DenWaritthon/CarverSeekBot/robot_description/models/Wheel.STL

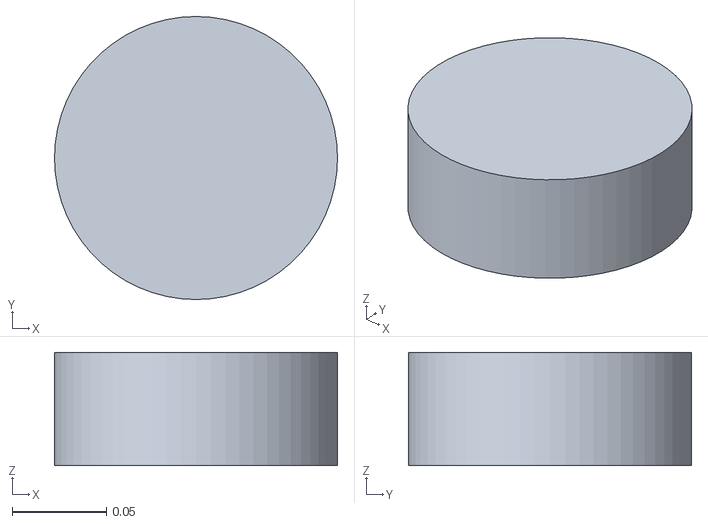
[picture p4: CAD file, 2025-05-24]
robot_description/models/Wheel.STL
0.15 x 0.15 x 0.06
