DenWaritthon/CarverSeekBot/robot_description/models/FrameNew.STL

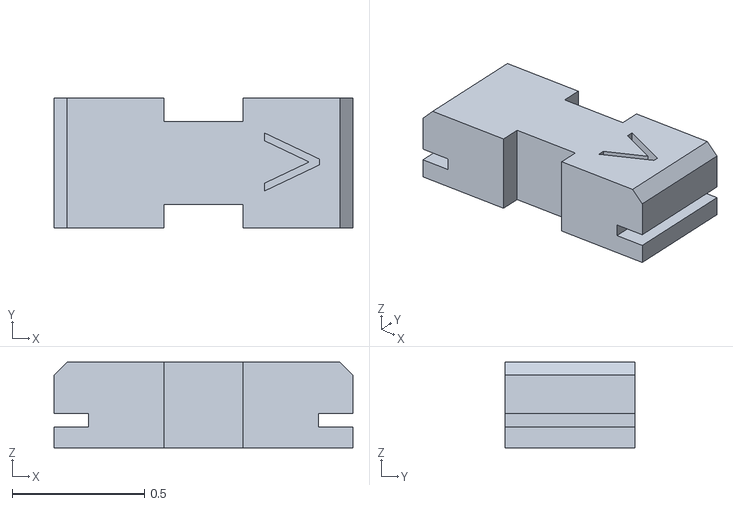
[picture p5: CAD file, 2025-05-24]
robot_description/models/FrameNew.STL
1.13 x 0.493 x 0.325
