DenWaritthon/CarverSeekBot/Electrical Schematic.pdf

-C1 | -C2

# Power Source (PSU Box)

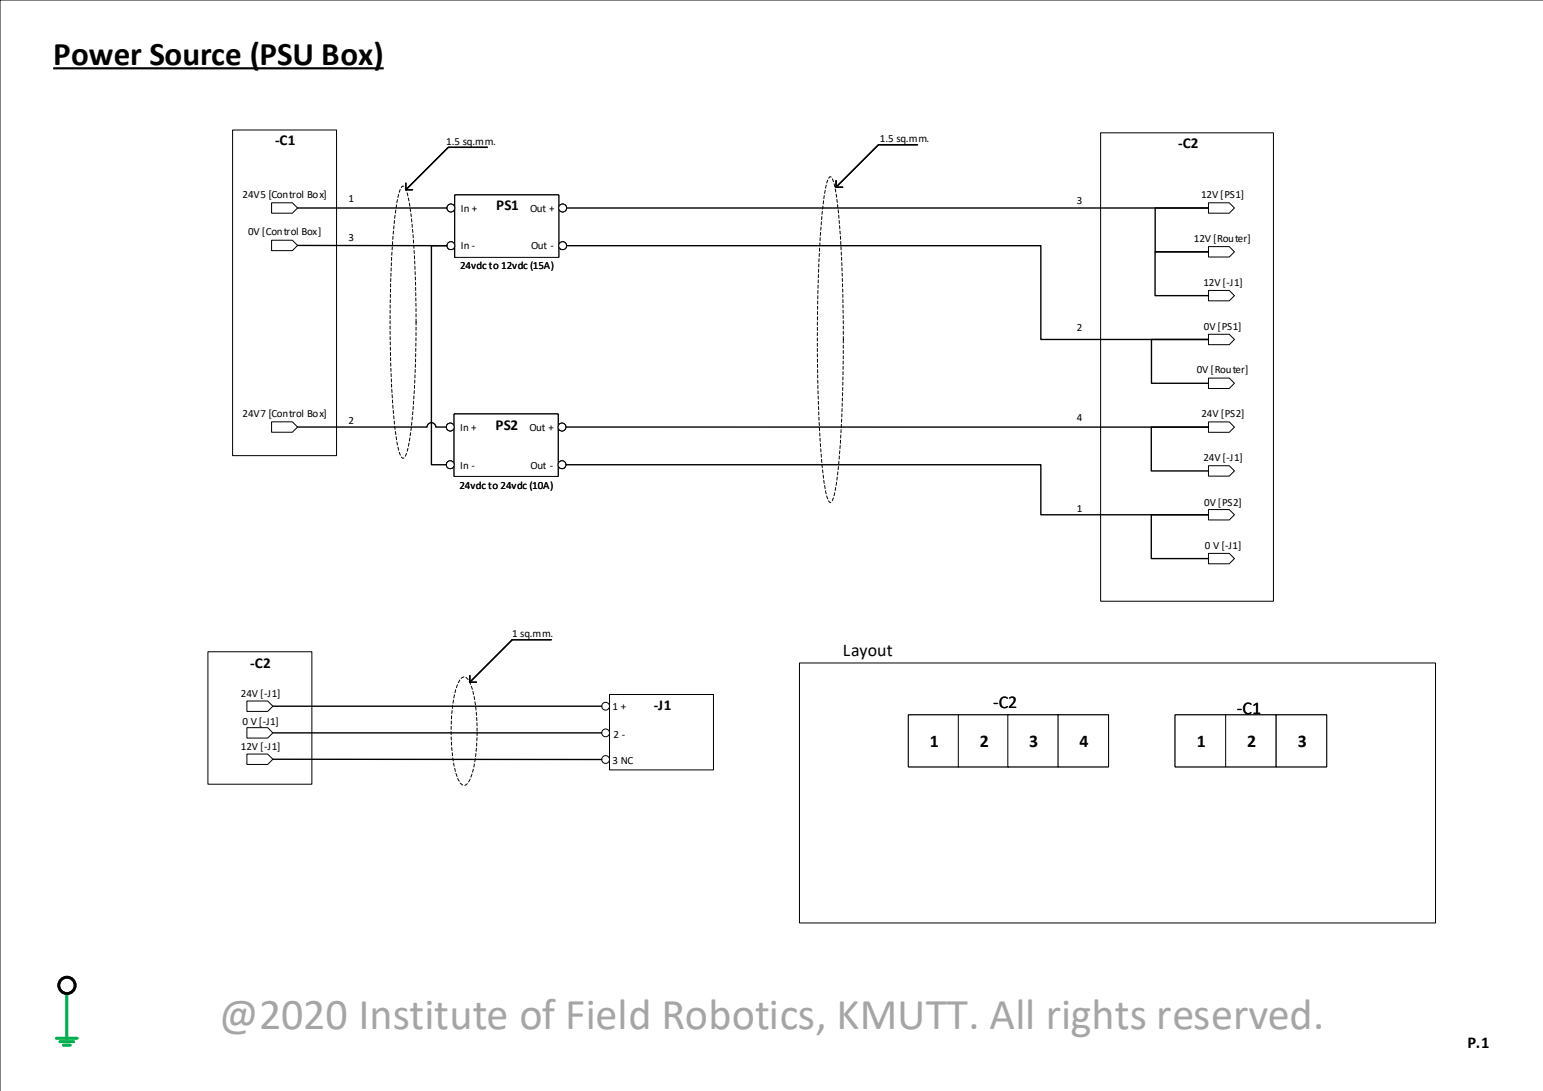
[picture p6: page 1]
Out +; Out -; 24vdc to 12vdc (15A); 0V [Control Box]; 24vdc to 24vdc (10A); 24V7 [Control Box]; 24V5 [Control Box]; 12V [Router]; 0V [Router]; Layout

@2020 Institute of Field Robotics, KMUTT. All rights reserved.

# Power Source (Control Box)

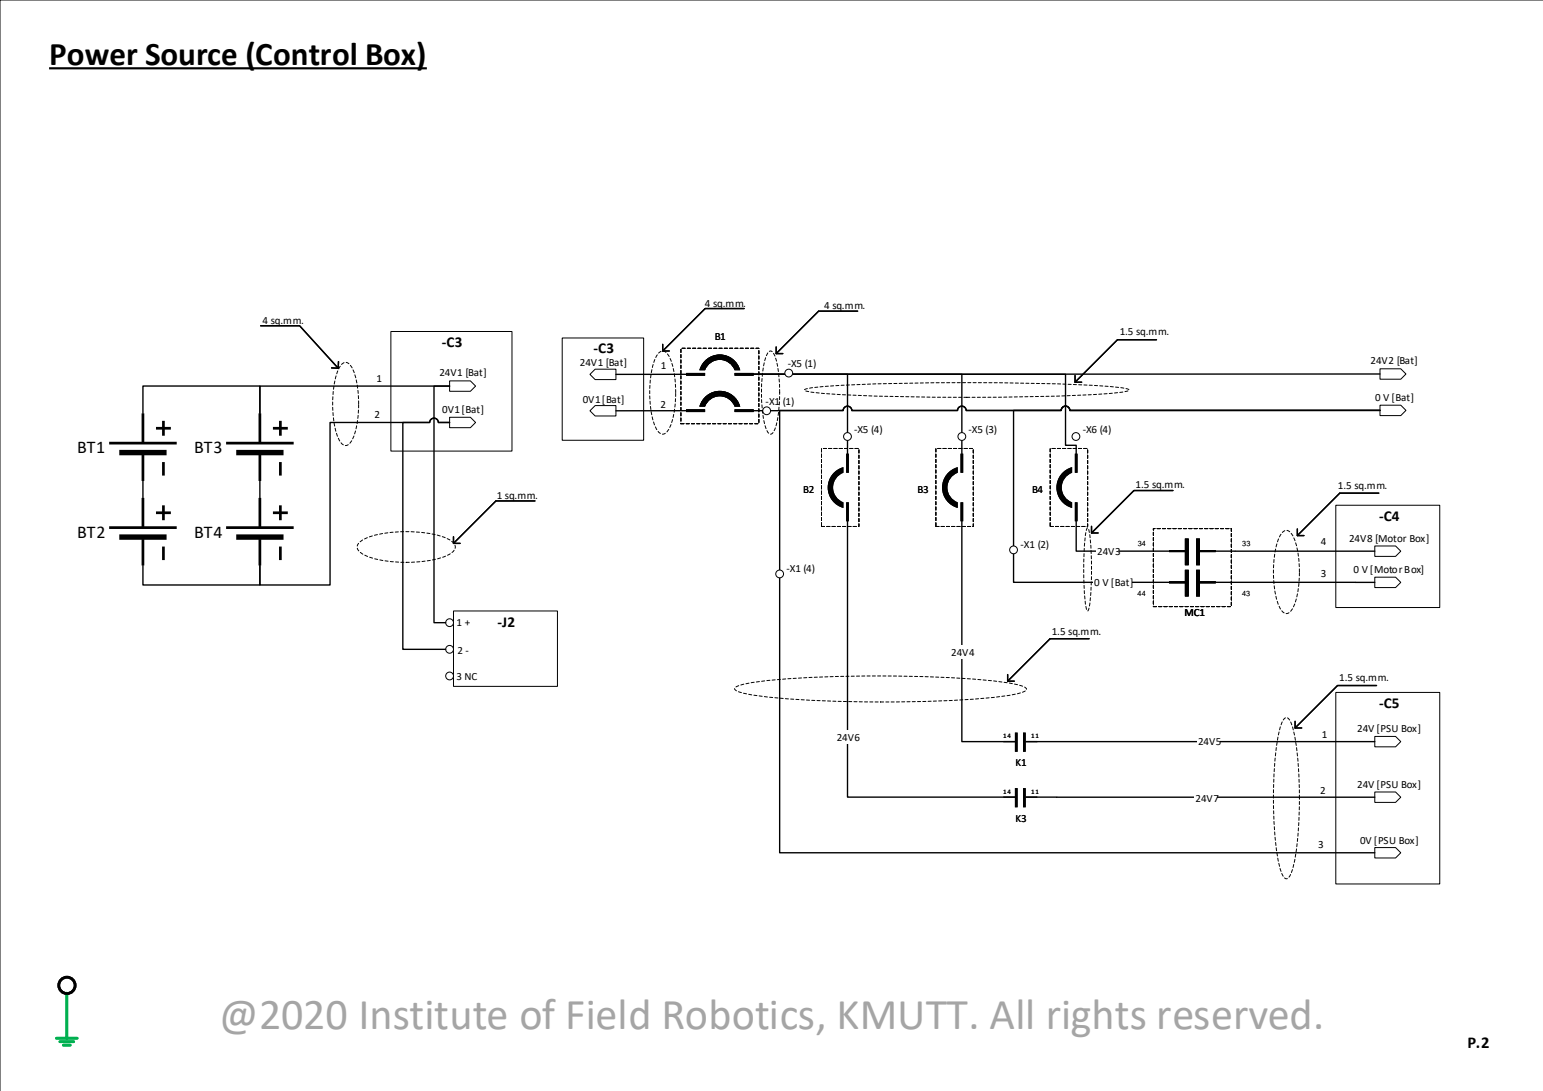
[picture p7: page 2]
24V2 [Bat]; 0 V [Bat]; 24V8 [Motor Box]; 0 V [Motor Box]; 24V [PSU Box]; 0V [PSU Box]; 24V1 [Bat]; 0V1 [Bat]

-C8

# Fused Module

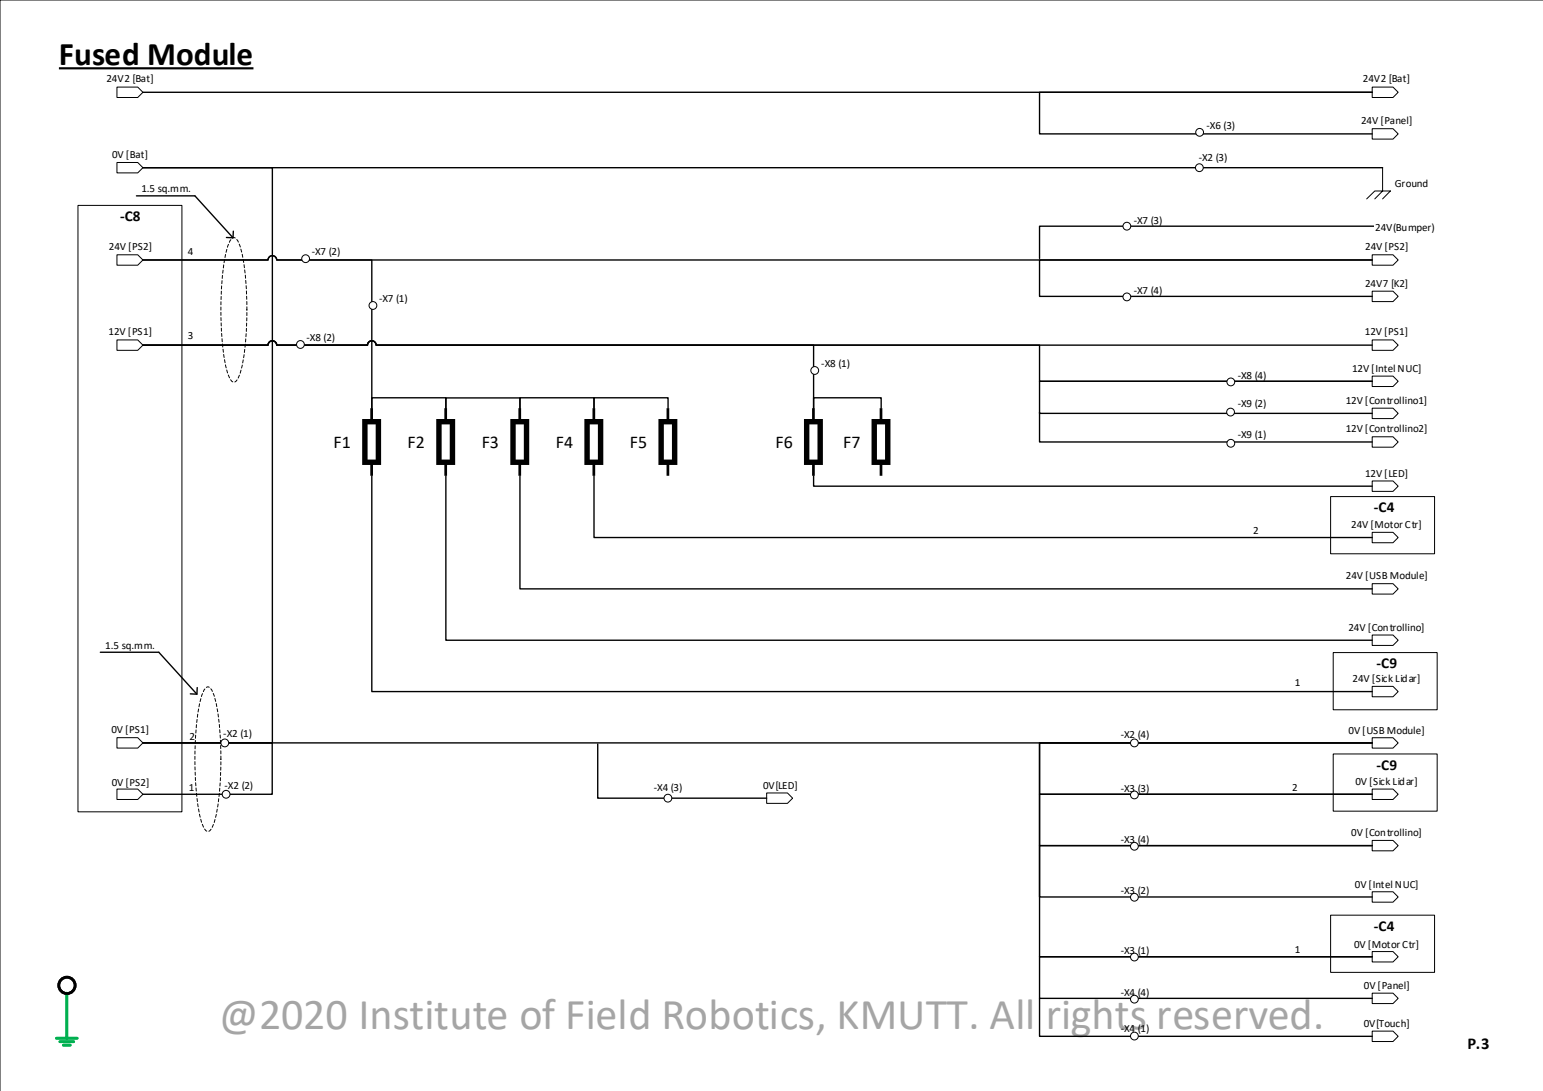
[picture p8: page 3]
24V2 [Bat]; 0V [Bat]; Ground; 24V [Sick Lidar]; 24V [Controllino]; 12V [LED]; 24V [USB Module]; 24V [Motor Ctr]; 0V [USB Module]; 0V [Sick Lidar]; 0V [Controllino]; 0V [Motor Ctr]; 12V [Intel NUC]; 0V [Intel NUC]; 24V [Panel]; 12V [Controllino1]; 0V [Panel]; 24V(Bumper) -X7 (3); 12V [Controllino2]; 0V[Touch]; 0V[LED]

-C6 | -C7

# Panel

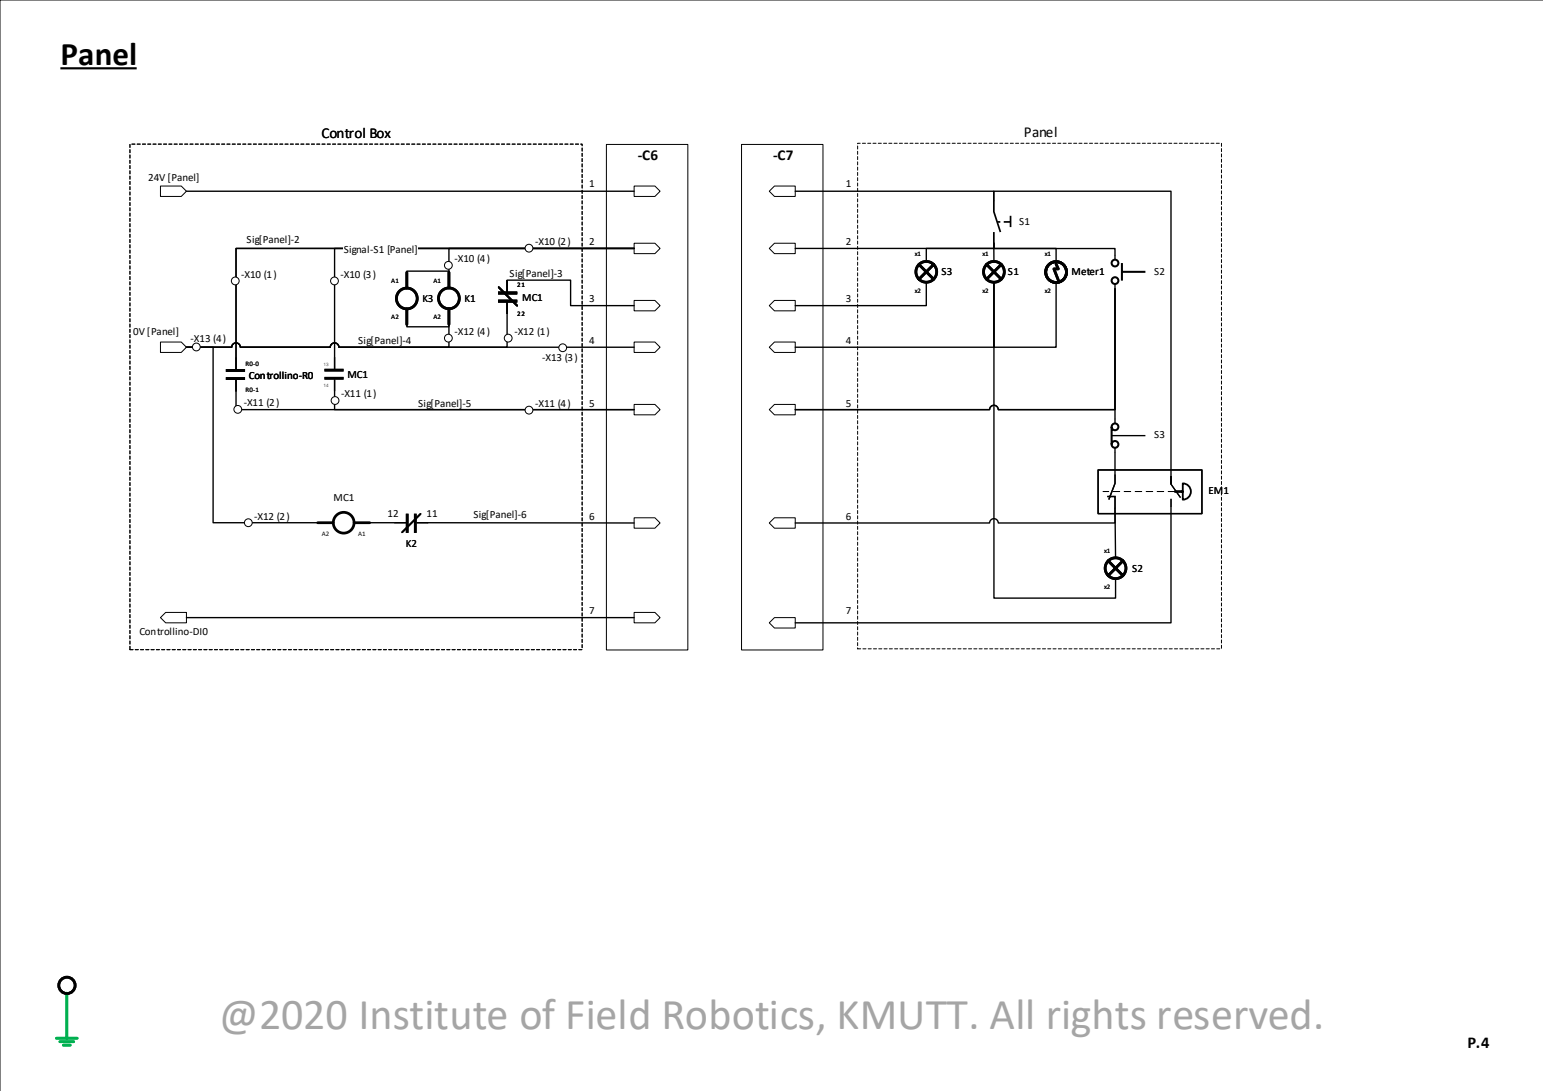
[picture p9: page 4]
24V [Panel]; 0V [Panel]; Signal-S1 [Panel]; Controllino-R0; Control Box; Panel; Controllino-DI0; Meter1; Sig[Panel]-2; Sig[Panel]-4; Sig[Panel]-3; Sig[Panel]-5; Sig[Panel]-6

-C10

# Motor Controller

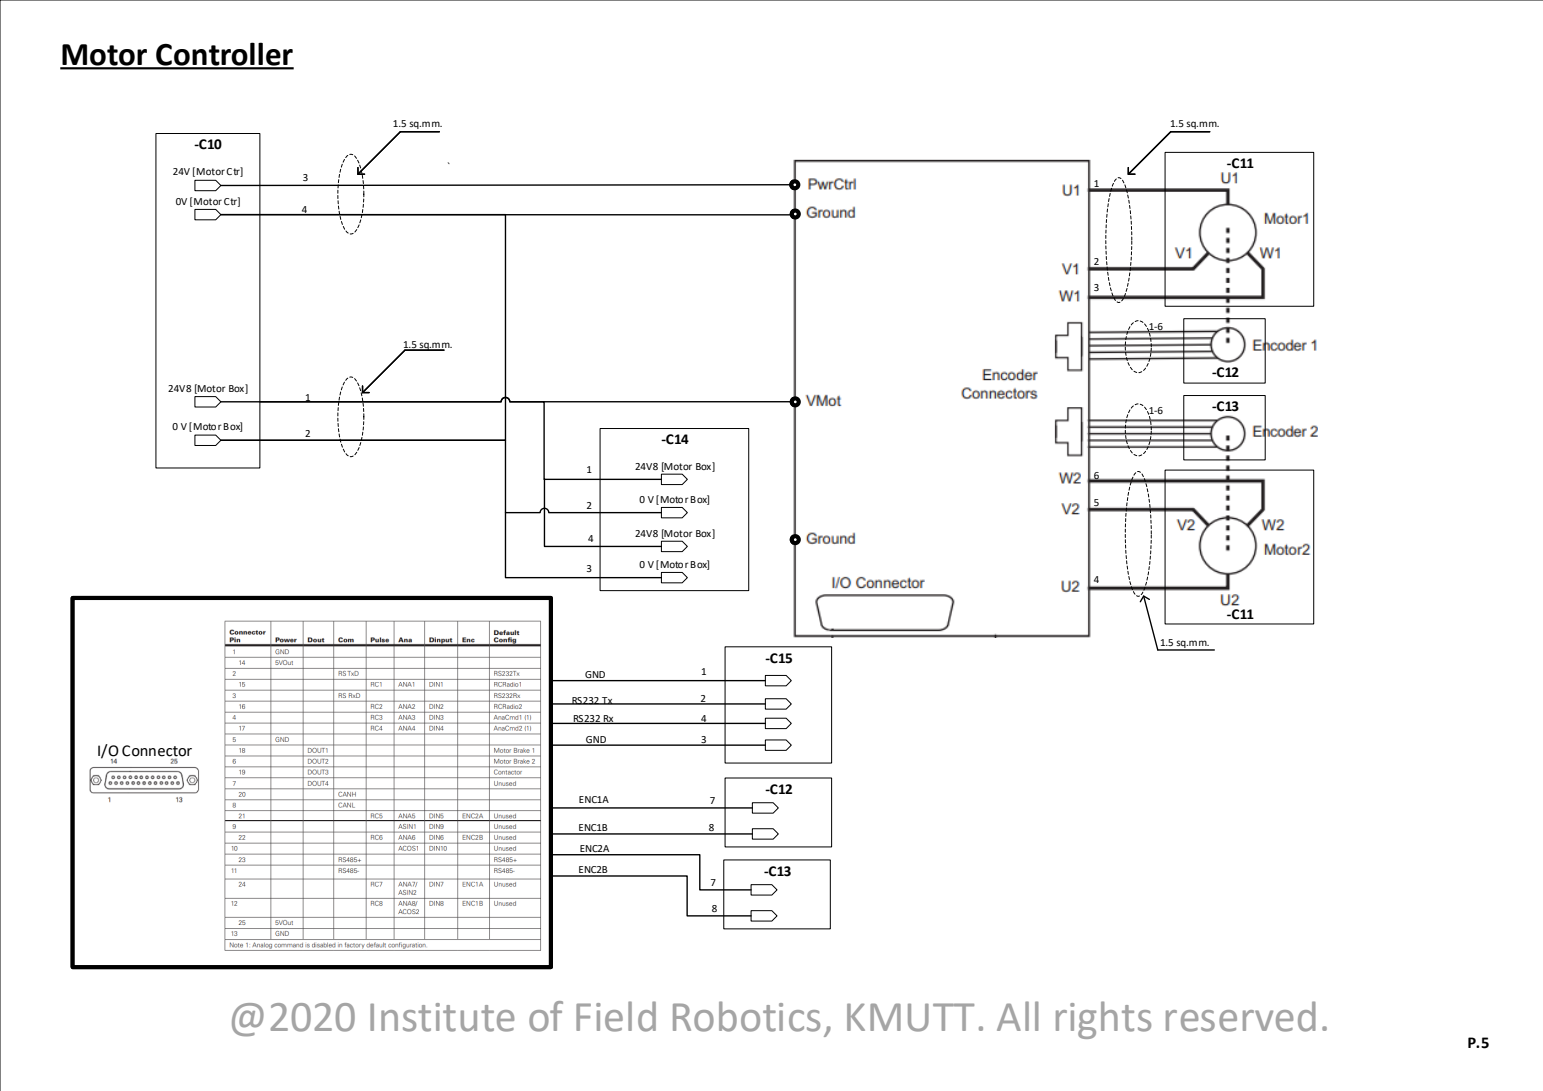
[picture p10: page 5]
I/O Connector; 24V [Motor Ctr]; 0V [Motor Ctr]; 24V8 [Motor Box]; 0 V [Motor Box]; GND; ENC1A; ENC1B; ENC2A

ENC2B

## For connector C12, C13

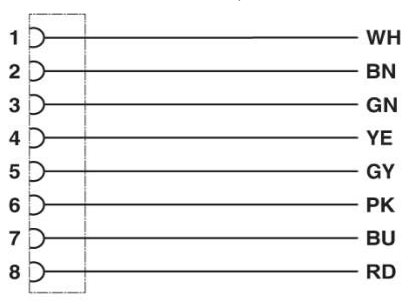
[picture p11: figure]
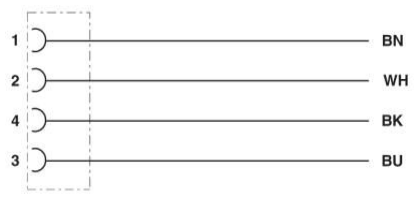
[picture p12: figure]
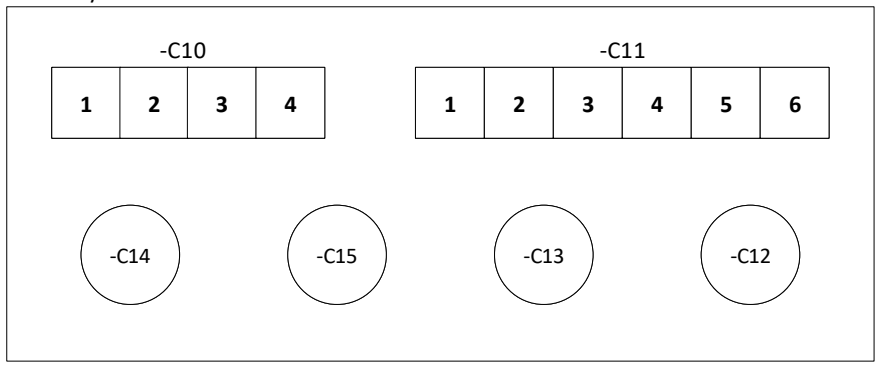
[picture p13: figure]

## Encoder Pin

# Motor Controller

P.6

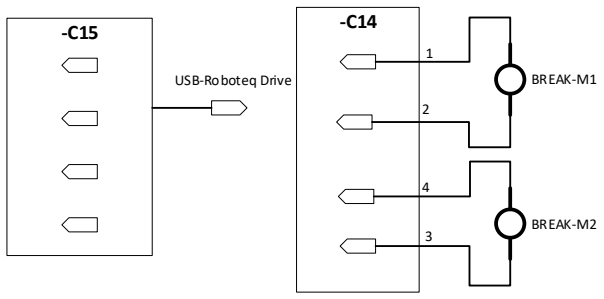
[picture p14: figure]
BREAK-M1; BREAK-M2; USB-Roboteq Drive

## For connector C14, C15

## Layout

# Controllino

R9

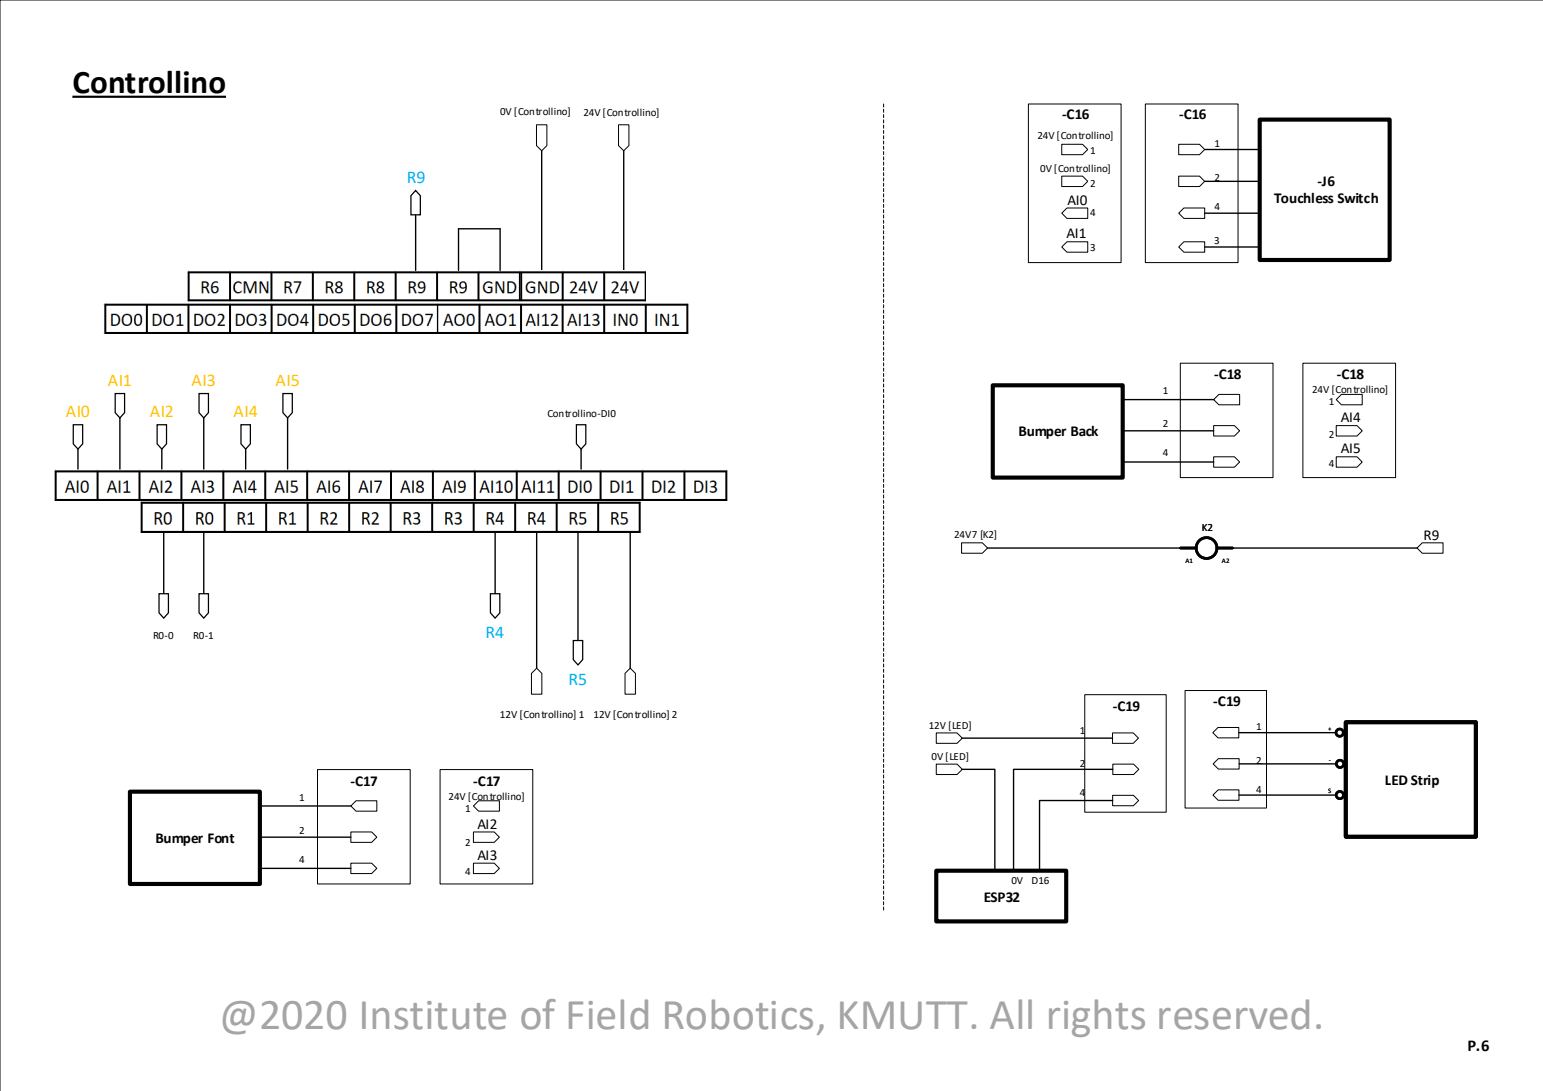
[picture p15: page 7]
Controllino-DI0; 0V [Controllino] 24V [Controllino]; 12V [Controllino] 2; -J6 Touchless Switch; LED Strip; Bumper Font; 24V [Controllino]; 0V [Controllino]; Bumper Back; 12V [Controllino] 1; ESP32; 12V [LED]; 0V [LED]

# Controller

## Control Box

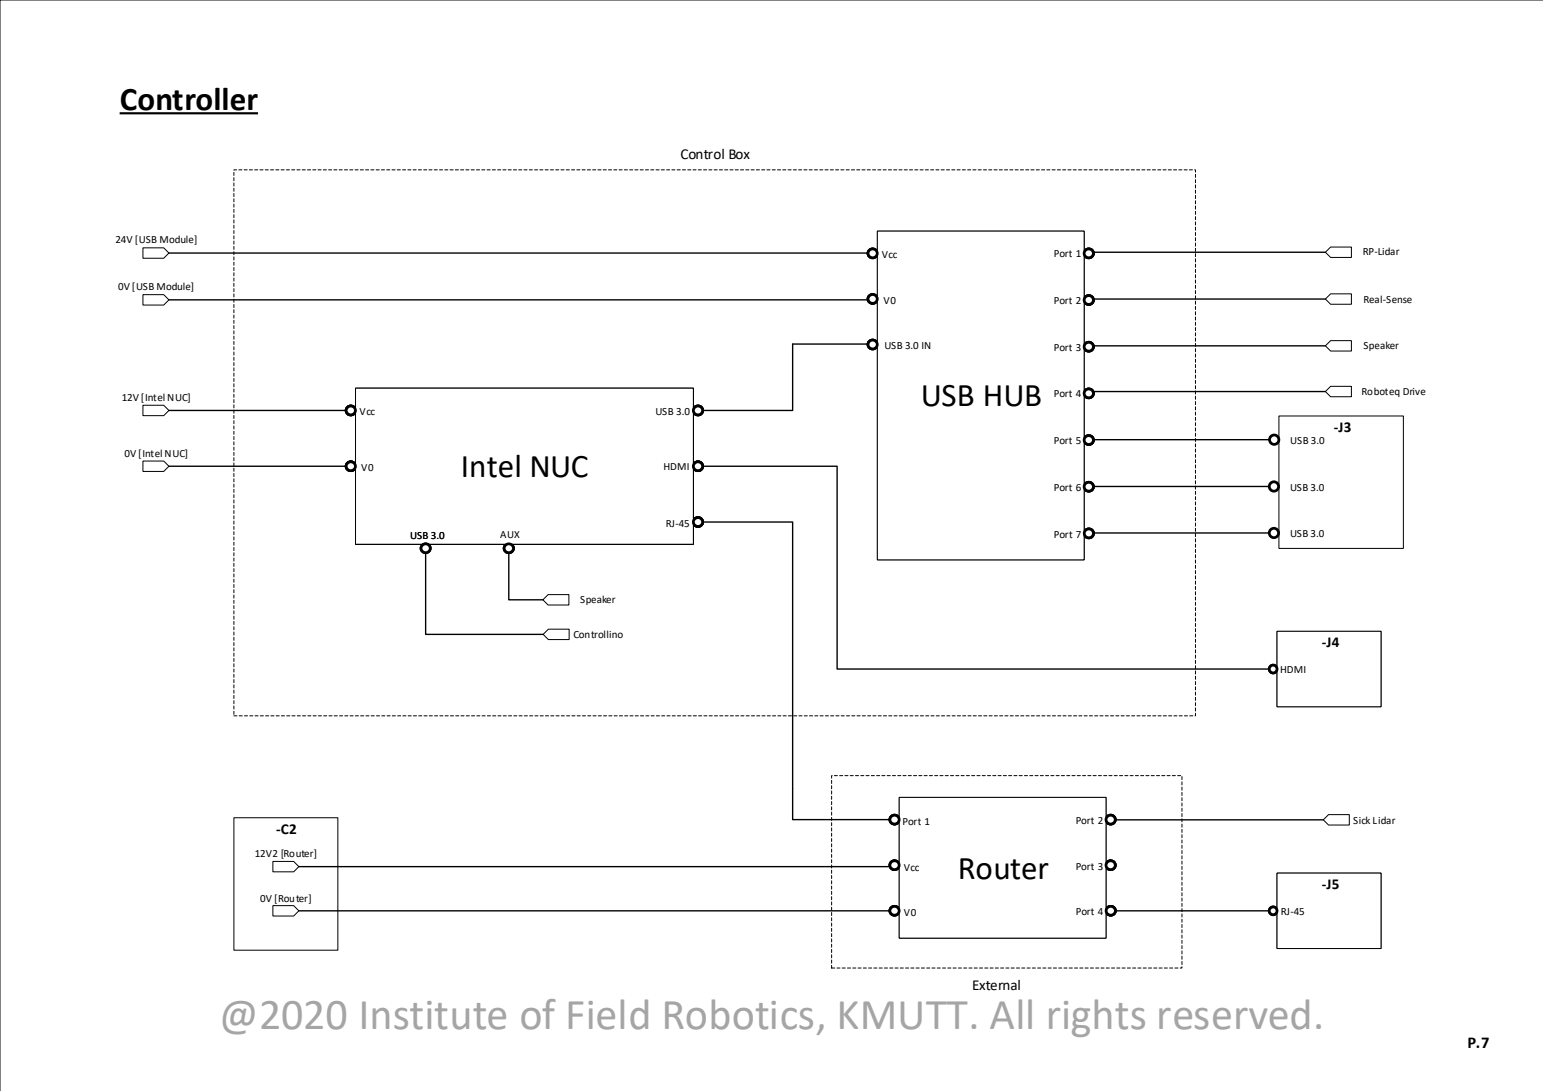
[picture p16: page 8]
0V [Intel NUC]; 12V [Intel NUC]; USB HUB; USB 3.0 IN; Vcc; Port 1; Port 2; Port 3; Port 4; Port 5; Port 6; Port 7; 24V [USB Module]; 0V [USB Module]; HDMI; USB 3.0; RP-Lidar; Real-Sense; Speaker; Roboteq Drive; Intel NUC; AUX; Router; 12V2 [Router]; 0V [Router]; Sick Lidar; External; Controllino

HDMI Intel NUC

## External Connector

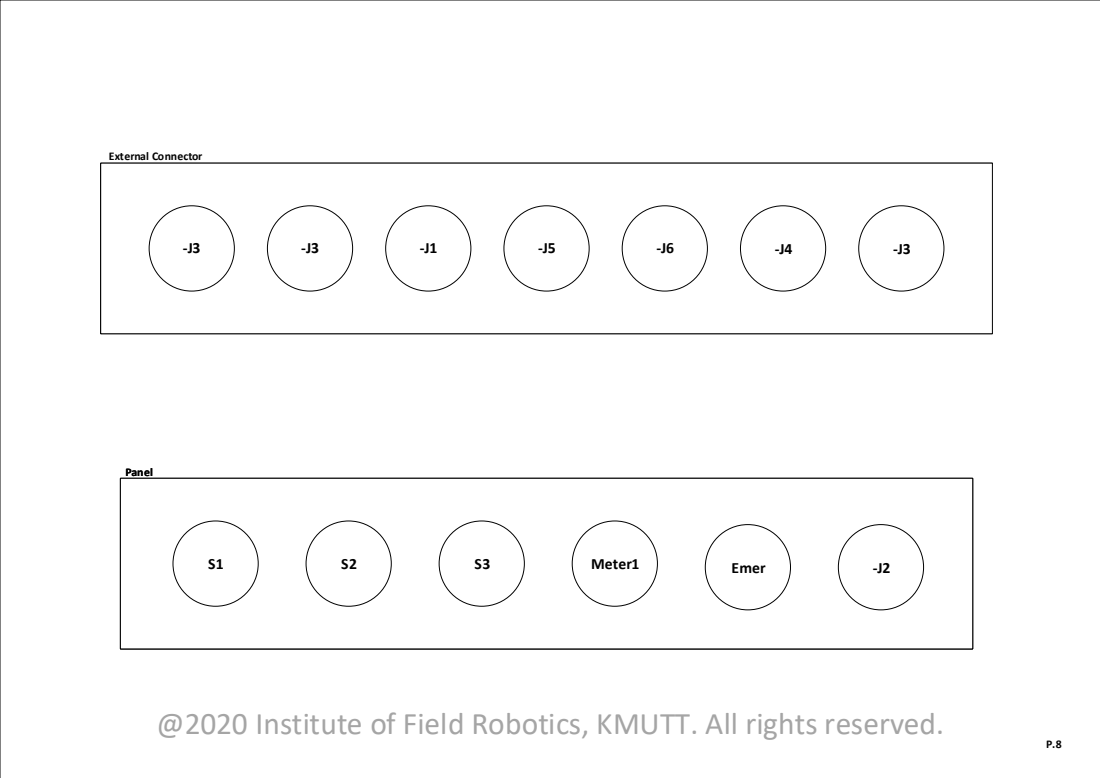
[picture p17: page 9]
Panel; Meter1; Emer

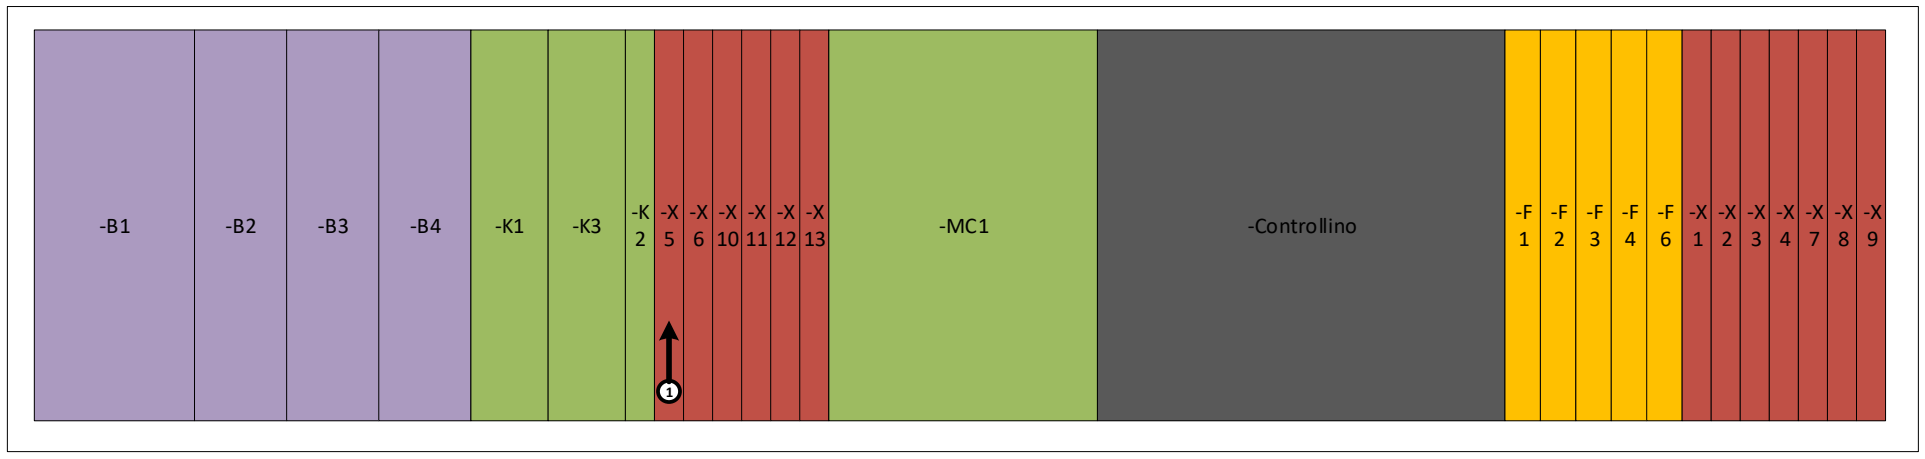
[picture p18: figure]
-Controllino

P.9

## Layout

## For connector C9, C16, C17, C18, C19

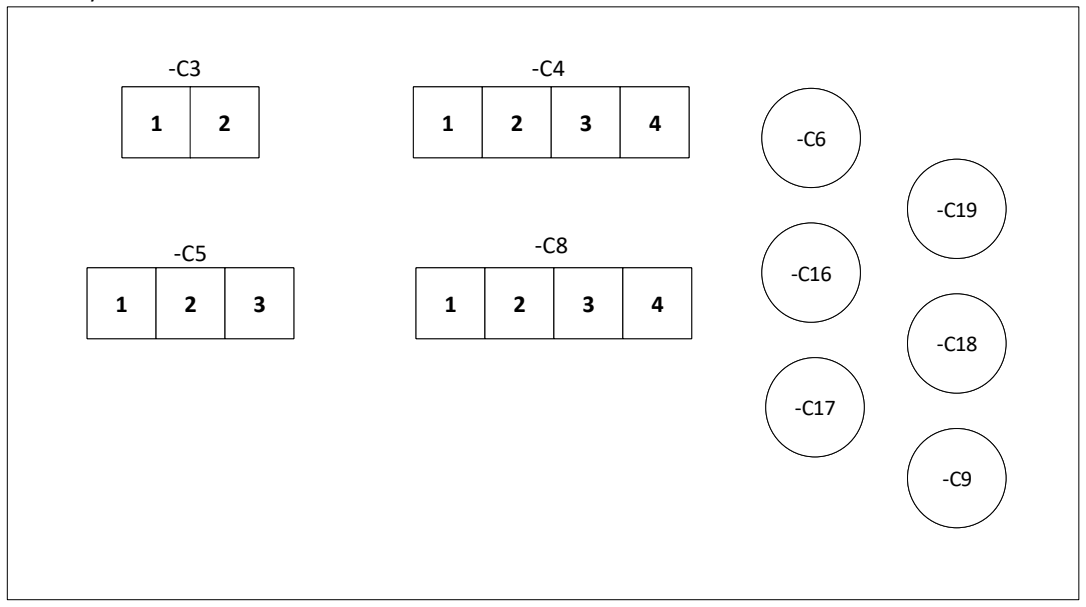
[picture p19: figure]

## For connector C6

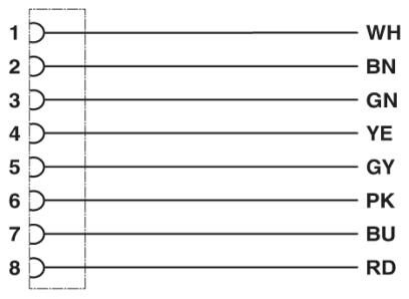
[picture p20: figure]
