DenWaritthon/CarverSeekBot/(commit log)

2025-05-17 Add modbus, Lidar and controller
2025-05-21 Update README, add sensor monitoring and control functionality, and modify launch files
2025-05-22 Refactor sensor callbacks to prevent multiple service calls on state changes and add state tracking for limit and emergency sensors
2025-05-22 Remove LED Controller
2025-05-24 Update launch lidar
2025-05-24 Add robot description
    [FrameNew.STL, Wheel.STL, carver_cap.xacro]
2025-05-24 Add static transform for back LIDAR and clean up parameters
2025-05-24 Refactor robot launch files and update RViz configurations for improved odometry and visualization
2025-05-25 Update Merge lidar
2025-05-25 Update lidar launch
2025-05-25 Update usb to fix name and add lidar to bringup
2025-05-26 Slam it's done now!!! because one 'true' parameter
    [imu_calibration.yaml]
2025-05-28 Update Carver 28/5/68
    [imu_calibration.yaml]
2025-05-28 Nav2 Wait to Tune AMCL
    [imu_calibration.yaml]
2025-05-29 Updatre paramenter
    [imu_calibration.yaml]
2025-05-31 Add electrical schematic
